neximind/NxBCI/Accessories List/Accessories List.md

| Accessory Name | Function | Appearance | Remarks |
| :---: | :---: | :---: | :---: |
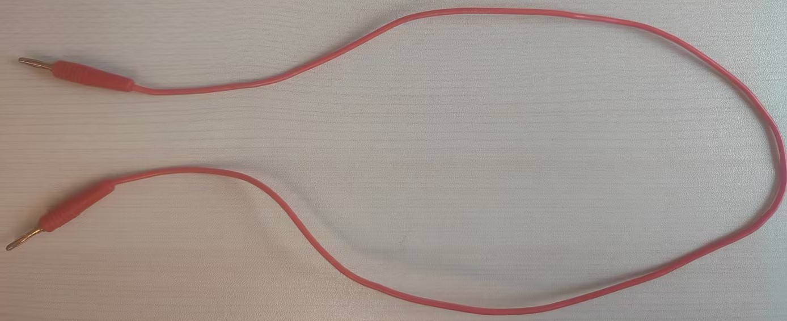
[picture p24: Accessories List/media/banana_cable.jpg]
banana plug cable
| 2mm double-ended banana plug cable | as part of the electrode lead assembly |  | Plug material: Gold-plated pure copper |
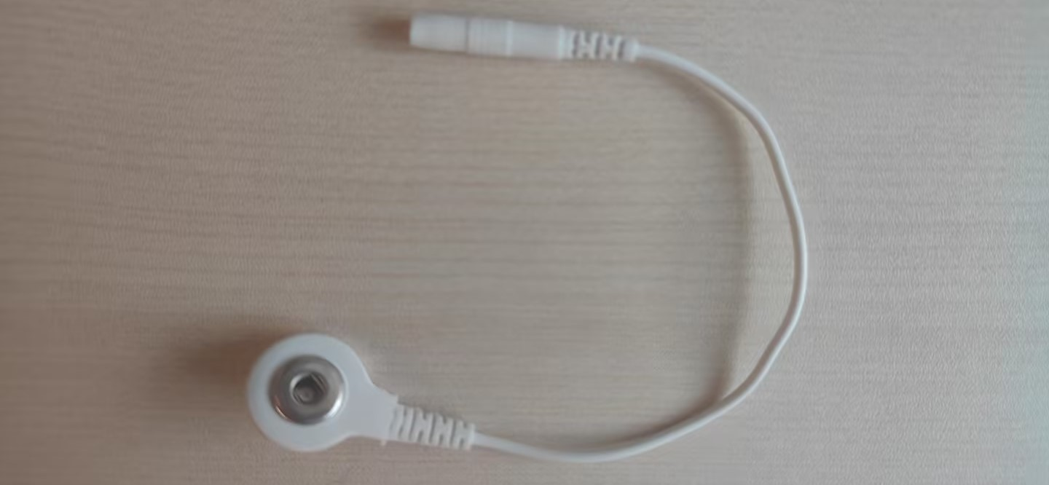
[picture p25: Accessories List/media/button_cable.jpg]
button_cable
| Button type electrode adapter cable | as part of the electrode lead assembly |  | 2mm to 3.5mm |
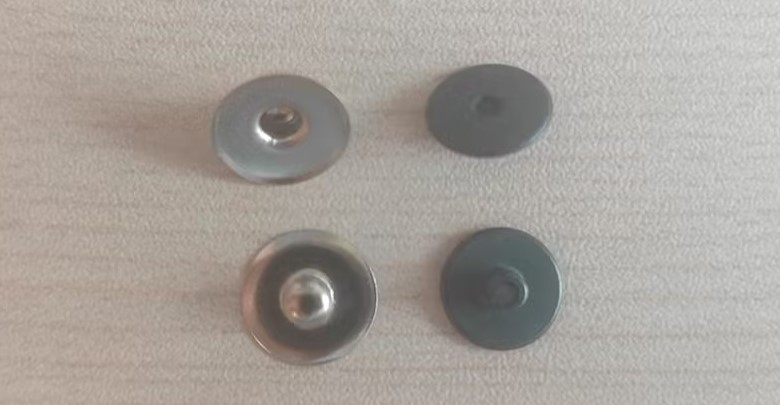
[picture p26: Accessories List/media/measuring_electrode.jpg]
measuring electrode
| 3.9mm electrode snap and silver chloride electrode | measuring electrode |  | The silver chloride electrode needs to be riveted into the electrode snap. |
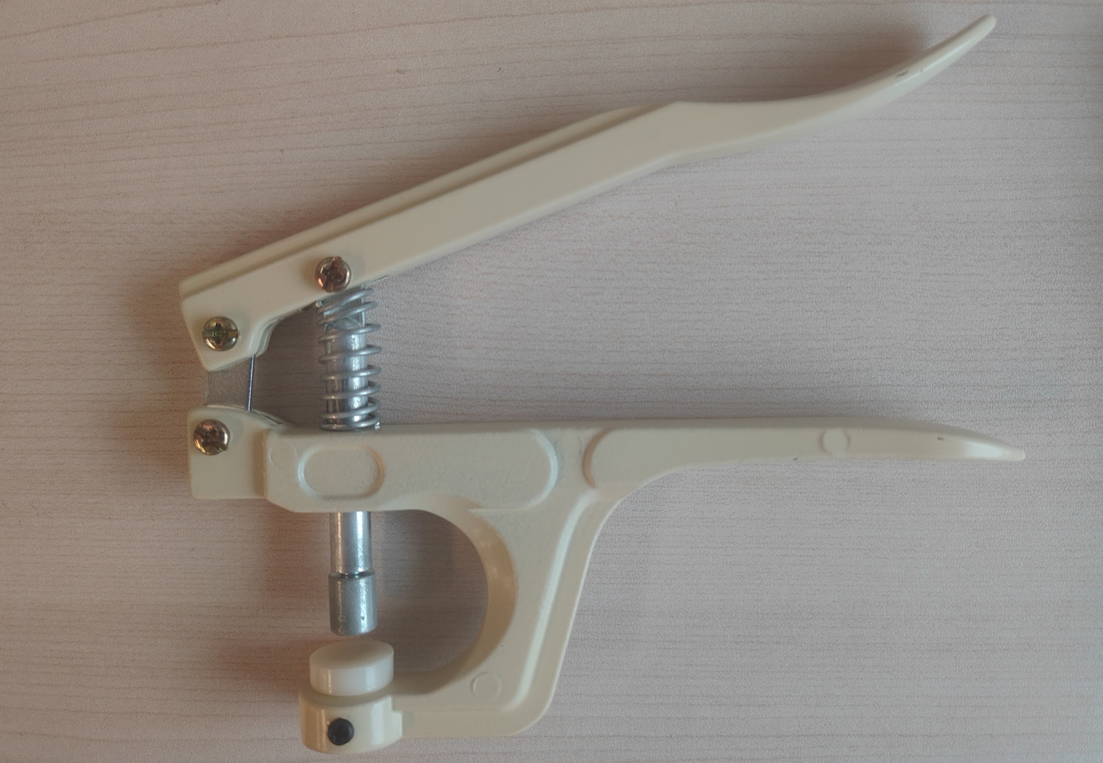
[picture p27: Accessories List/media/riveting_pliers.jpg]
riveting pliers
| manual riveting pliers | making measuring electrodes |  | Avoid electrode damage during use |
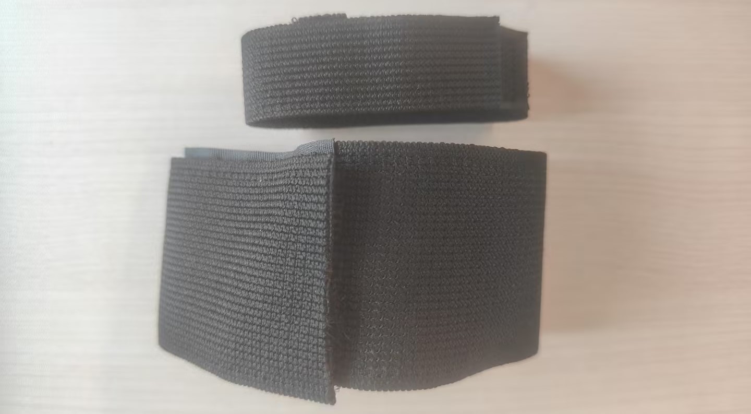
[picture p28: Accessories List/media/elastic_strap.jpg]
velcro elastic strap
| velcro elastic strap | wearable electrode securing device |  | measuring electrode:5mm-wide strap;<br />reference electrode:2mm-wide strap |
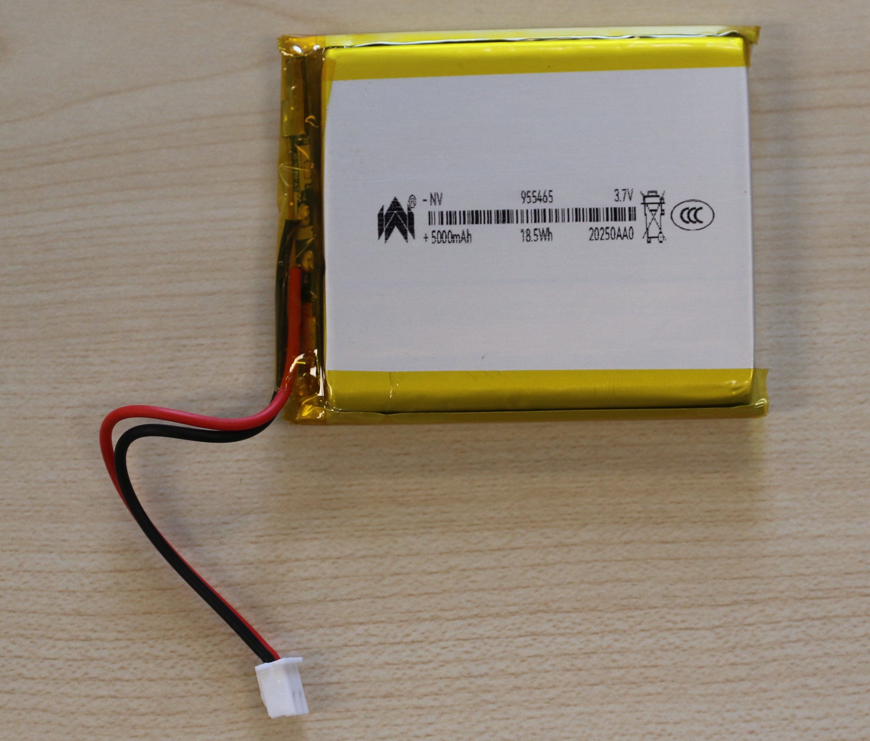
[picture p29: Accessories List/media/lithium-ion_ battery.jpg]
lithium-ion battery
| 5000mAh lithium-ion polymer battery | as the power source for the device |  | Dimensions: 65mm× 55mm × 9.5mm;<br />Equipped  with a protection board and a 2.54 connector power cord |
