neximind/NxBCI/Accessories List/Accessories List.pdf

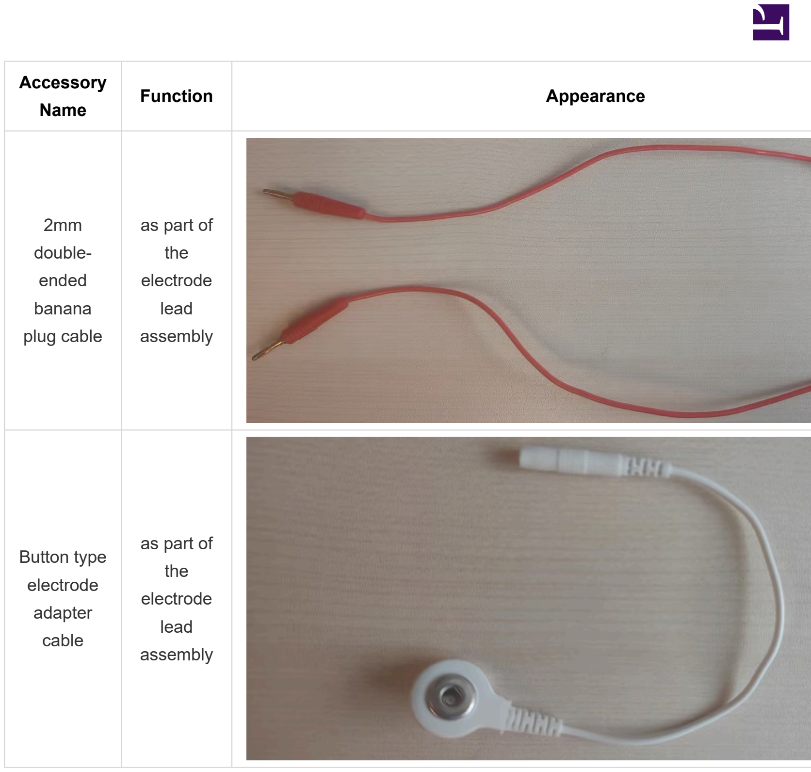
[picture p30: page 1]

Accessory
Name
Function | Appearance

2mm
doubleended
banana
plug cable

as part of
the
electrode
lead
assembly

Button type
electrode
adapter
cable

as part of
the
electrode
lead
assembly

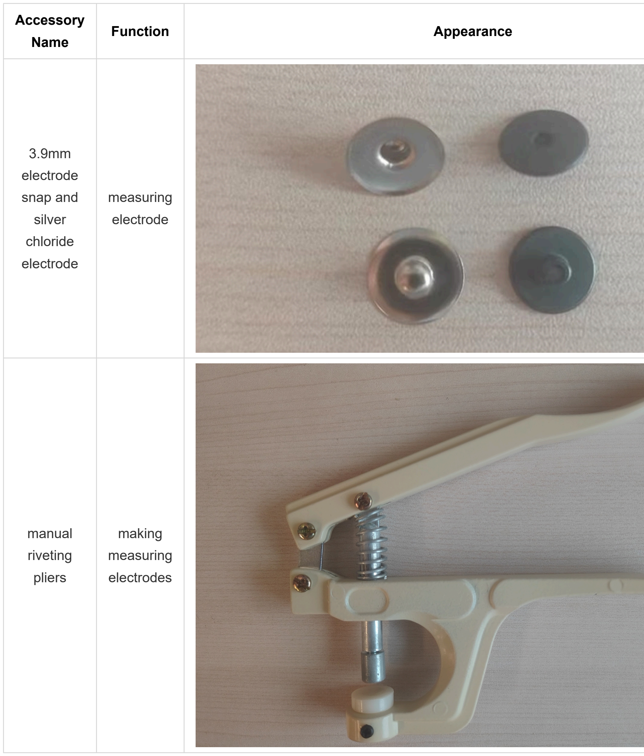
[picture p31: page 2]

Accessory
Name
Function | Appearance

3.9mm
electrode
snap and
silver
chloride
electrode

measuring
electrode

manual
riveting
pliers

making
measuring
electrodes

Accessory
Name
Function | Appearance

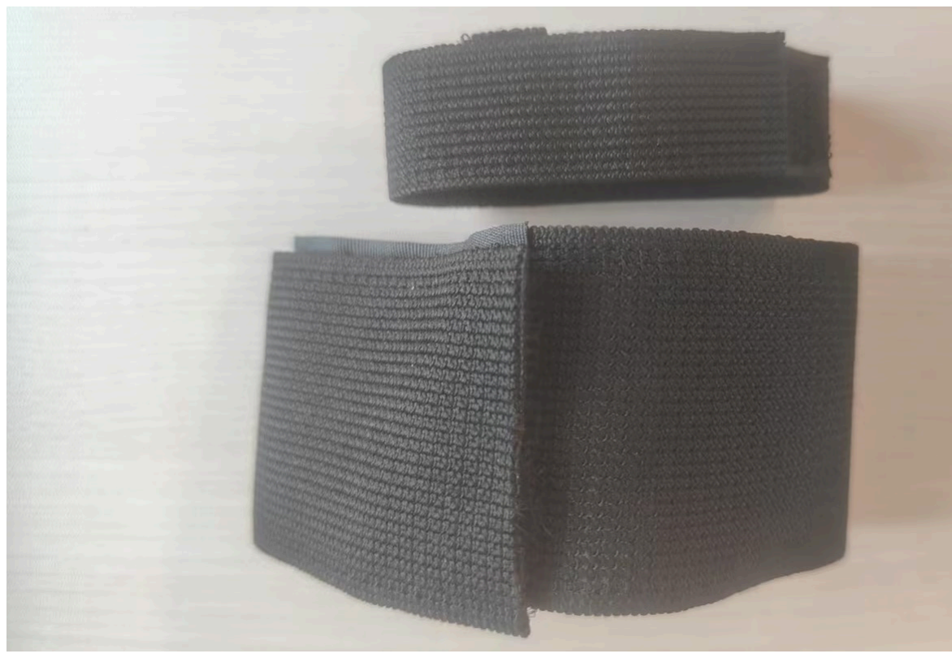
[picture p32: figure]

velcro
elastic
strap

wearable
electrode
securing
device

Accessory
Name
Function | Appearance

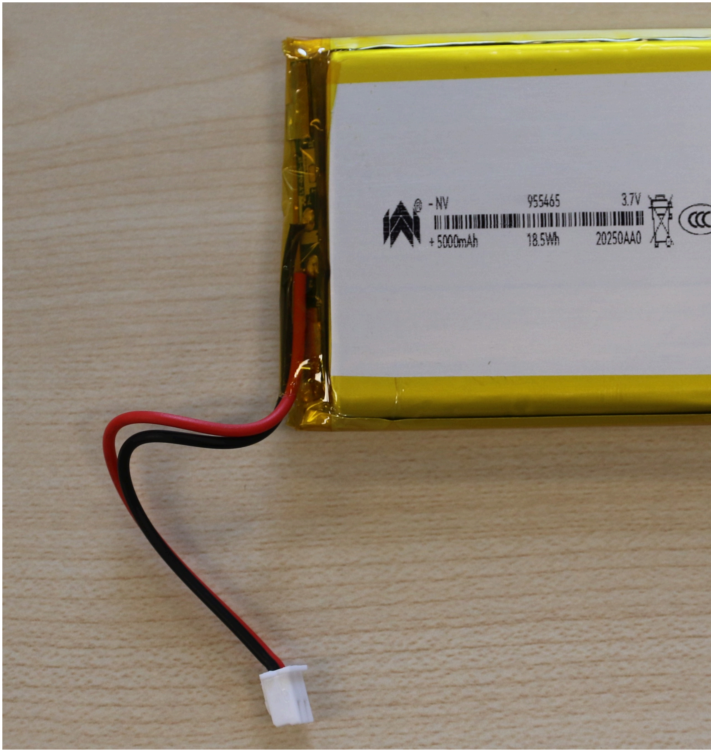
[picture p33: figure]

5000mAh
lithium-ion
polymer
battery

as the
power
source for
the device
