neximind/NxBCI/application/GesturesRecognition/images/fist.png

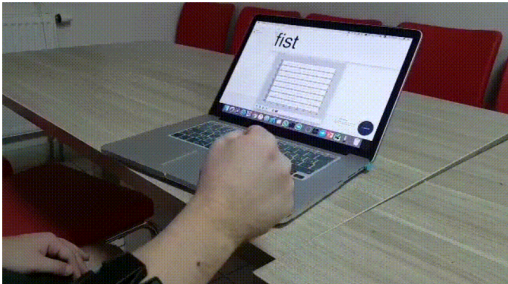
application/GesturesRecognition/images/fist.png
