neximind/NxBCI/application/GesturesRecognition/images/left.png

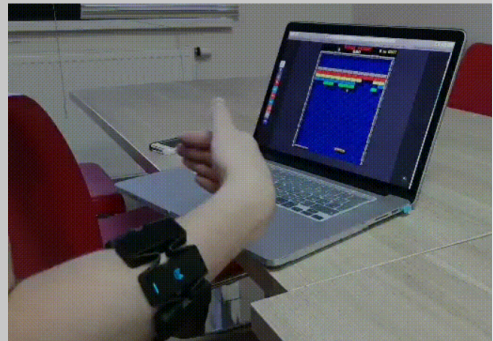
application/GesturesRecognition/images/left.png
