neximind/NxBCI/application/GesturesRecognition/images/open_hand.png

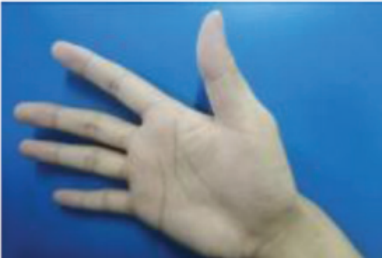
application/GesturesRecognition/images/open_hand.png
