neximind/NxBCI/application/GesturesRecognition/images/relax.png

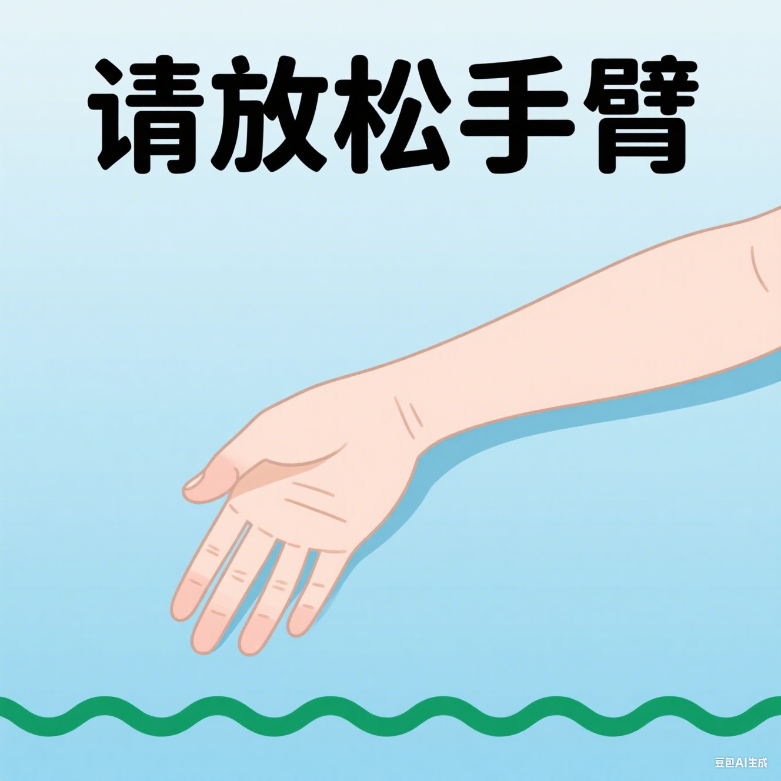
application/GesturesRecognition/images/relax.png
