neximind/NxBCI/application/GesturesRecognition/images/right.png

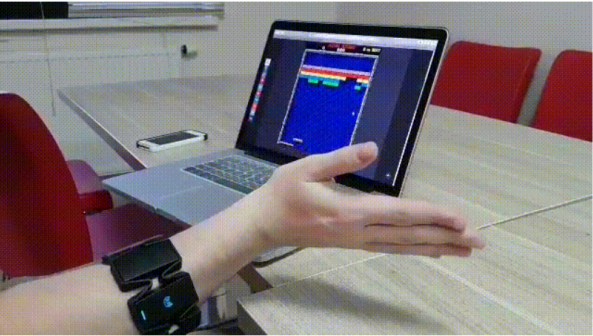
application/GesturesRecognition/images/right.png
