neximind/NxBCI/application/GesturesRecognition/images/yes.png

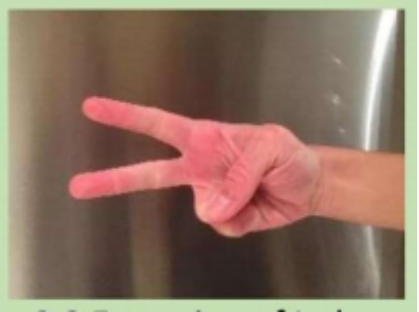
application/GesturesRecognition/images/yes.png
