neximind/NxBCI/media/image/default.jpg

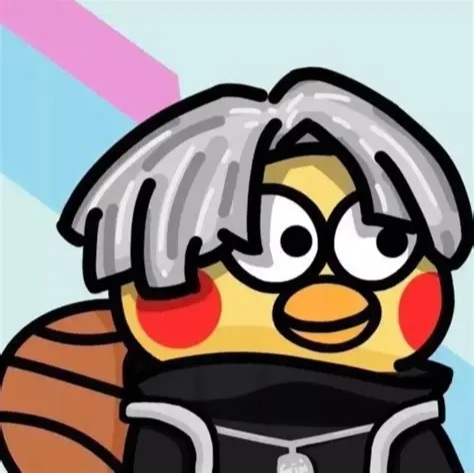
media/image/default.jpg
