neximind/NxBCI/media/image/kit_0.jpg

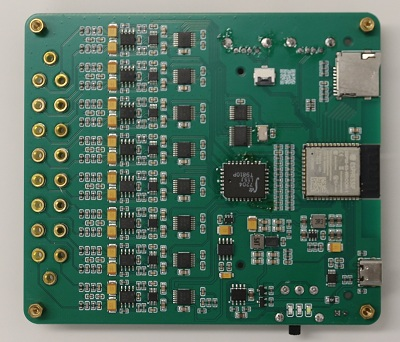
media/image/kit_0.jpg
