neximind/NxBCI/media/image/kit_1.jpg

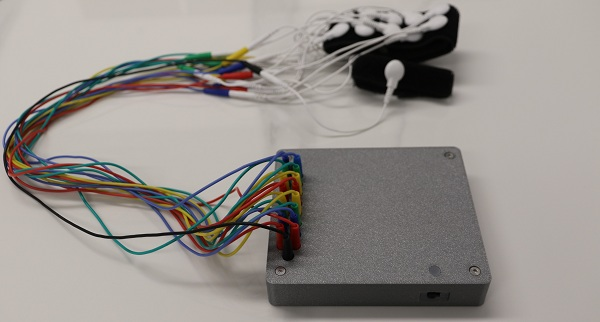
media/image/kit_1.jpg
