neximind/NxBCI/media/image/nxbci_0.jpg

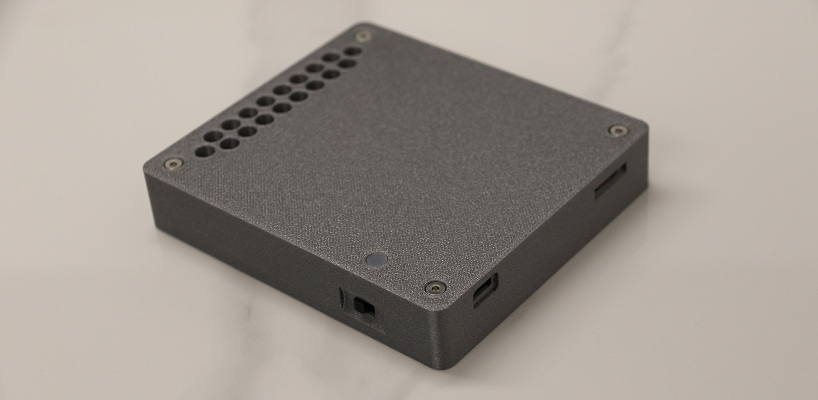
media/image/nxbci_0.jpg
