neximind/NxBCI/More About NxBCI/Active electrode.jpg

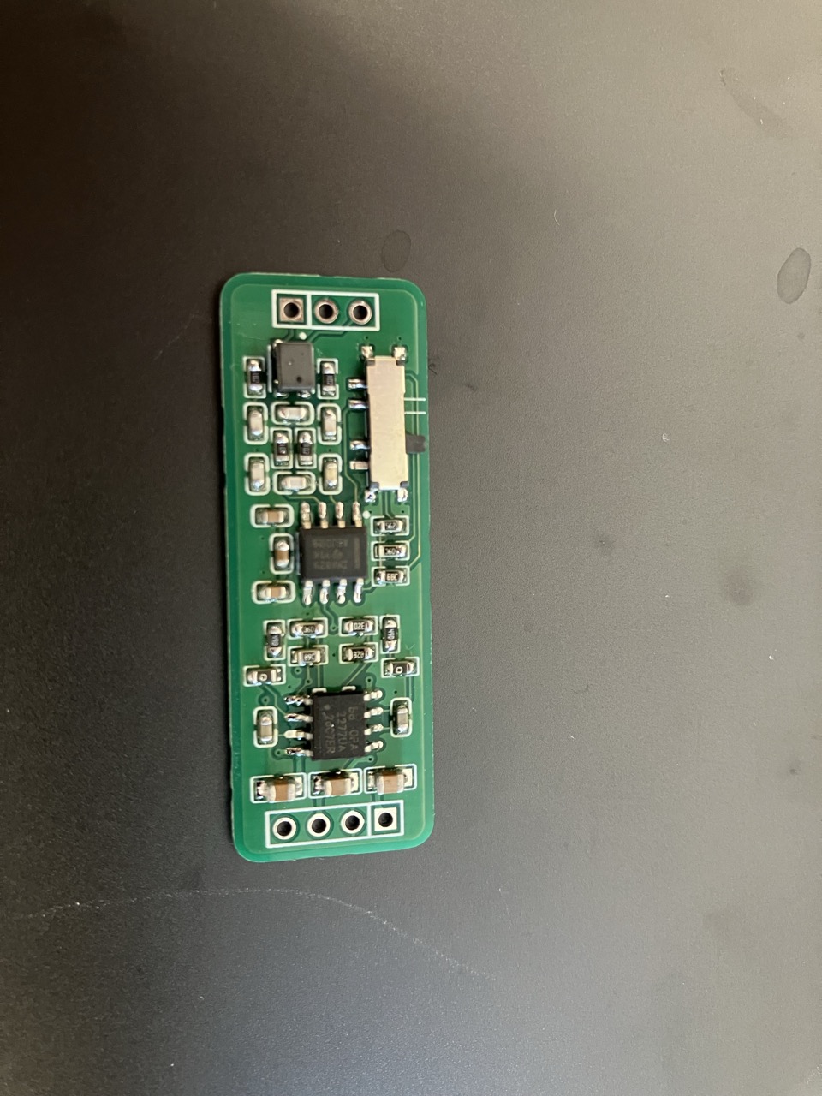
More About NxBCI/Active electrode.jpg
