neximind/NxBCI/Software Documents/IOS/Image/connected.jpeg

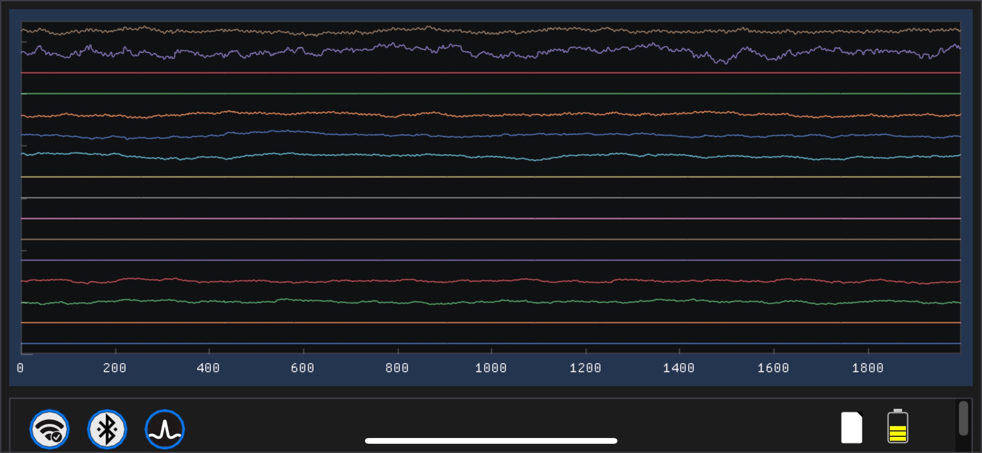
Software Documents/IOS/Image/connected.jpeg
