neximind/NxBCI/Software Documents/IOS/Image/keyboard_large.PNG

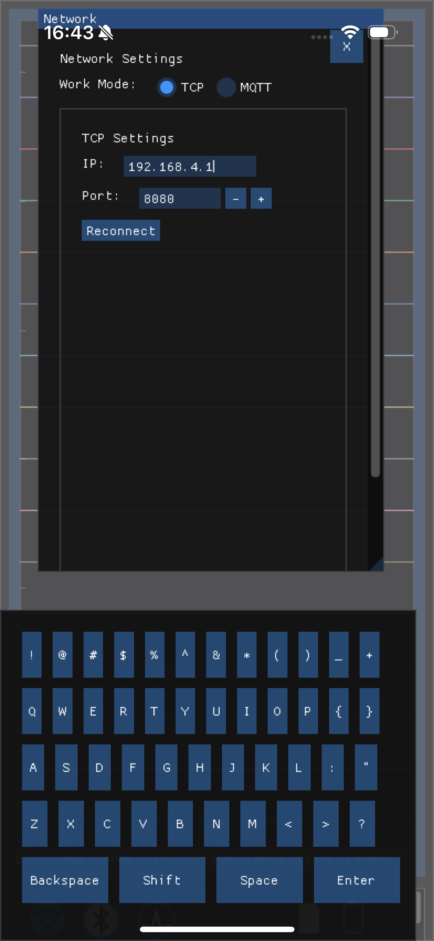
Software Documents/IOS/Image/keyboard_large.PNG
