neximind/NxBCI/Hardware/How to DIY Electrode Sleeve.md

# Electrode Sleeve DIY Guide

1.  Prepare the materials for making the electrode sleeve.

    <div align="left">
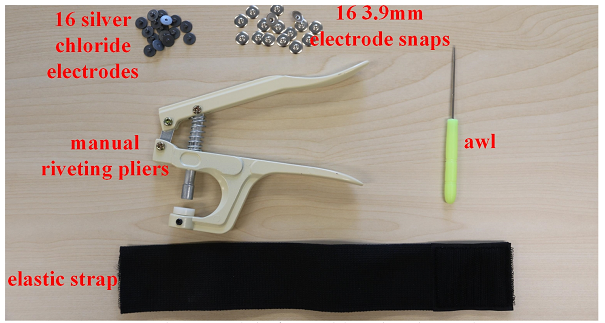
[picture p58: Hardware/media/sleeve_1.png]
Materials for the electrode sleeve
        
    </div>

2.  Punch holes at the appropriate positions with an awl and thread the silver chloride electrodes through.

    <div align="left">
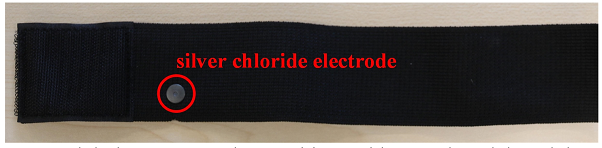
[picture p59: Hardware/media/sleeve_2.png]
Punching holes and threading electrodes
        
    </div>

3.  Use manual riveting pliers to rivet the 3.9mm electrode snaps and the silver chloride electrodes together.

    <div align="left">
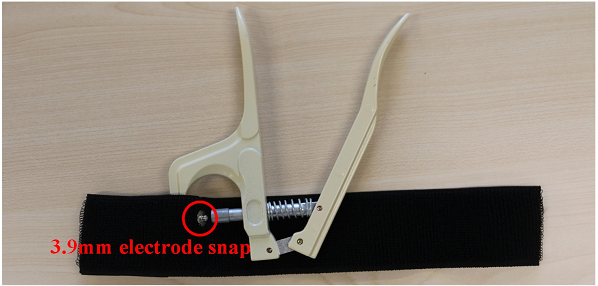
[picture p60: Hardware/media/sleeve_3.png]
Riveting the electrode snaps
        
    </div>

4.  Repeat steps 2 and 3 until all 16 electrodes are fully riveted, with the horizontal and vertical spacing between each electrode being approximately 20mm.

    <div align="left">
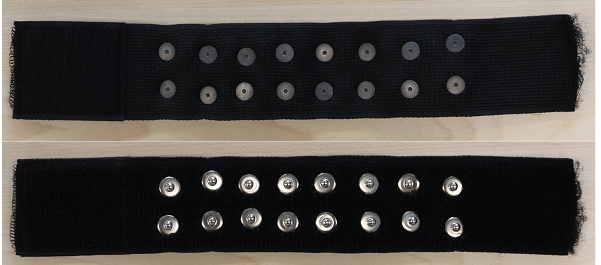
[picture p61: Hardware/media/sleeve_4.png]
Completed electrode sleeve
        
    </div>
