neximind/NxBCI/Hardware/media/install_6.png

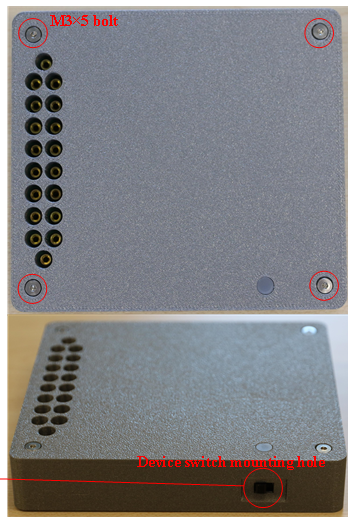
Hardware/media/install_6.png
