neximind/NxBCI/More About NxBCI/ac_amp.asc

C1: cap; 10µ
C2: cap; 470µ
C3: cap; 1n
C4: cap; 100p
R1: res; 10k
R2: res; 1k
R3: res; 1Meg
R4: res; 60k
U1: AD8629
V3: voltage; SINE(200m 100u 10); AC 1m; Rser=0
V5: voltage; 2.5
V6: voltage; 2.5
Named nets: 0, Vcc, Vee, VOUT
.tran 0 2 1
.ac oct 100 0.1 16000
.noise V(Vout) V3 oct 1000 0.1 1000
