neximind/NxBCI/(commit log)

2025-08-01 add DIY guide of Electrode sleeve
2025-09-08 update the data format of the device
2025-11-05 更新 TCP_Receiver_demo.py 的功能
2026-02-05 fix:fix the error path of the csv file
    [TCP_Receiver.py]
