neximind/NxBCI/(notices)

Notices in the files:
PythonSDK/Readme_zh.md:
License: MIT
